rbmj/Geiger_Counter/README.md

This is version 13 of the firmware. It displays counts per second, every second.
