rbmj/Geiger_Counter/Production Files/Geiger_Counter-Panel-v40.brd

## EAGLE design Production/Geiger_Counter-Panel-v40.brd (2014-09-24, last stored version)

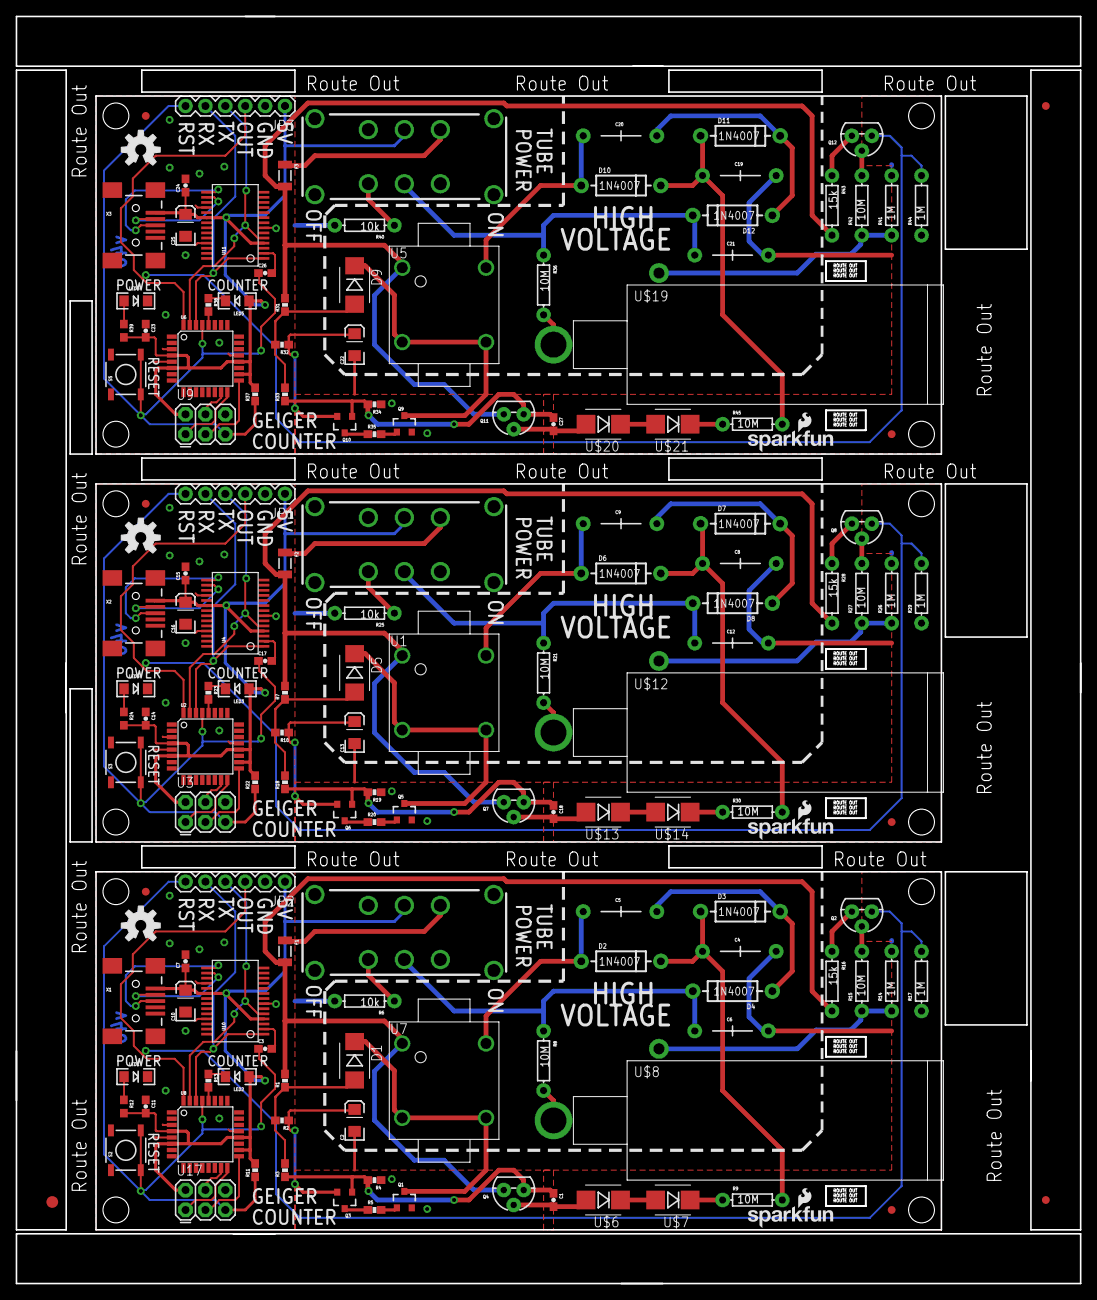
[picture p3: board Geiger_Counter-Panel-v40.brd from above]

Board: 2 copper layers, 135.9 x 161.8 mm, 165 parts (0 on the bottom side), 105 nets.

Parts:
C1, C3, C7, C11, C14, C15, C17, C18, C23, C24, C26, C27: 0.1uF; 0603-CAP
C2, C10, C13, C16, C22, C25: 10uF; EIA3216
C4, C5, C6, C8, C9, C12, C19, C20, C21: 0.01uF; CAP-PTH-LARGE
D1, D5, D9: 1N4007; DIODE-HV
D2, D3, D4, D6, D7, D8, D10, D11, D12: 1N4007; DIODE-1N4001
E$1: FIDUCIAL-1.5X3
E$2, E$3: FIDUCIAL-1X2
F1, F2, F3: PTCSMD; PTC-1206
FID1, FID2, FID3, FID4, FID5, FID6: FIDUCIAL1X2; FIDUCIAL-1X2
JP1, JP2, JP3: debug; 1X06
LED1, LED4, LED6: Red; LED-1206
LED2, LED3, LED5: Green; LED-1206
LOGO1, LOGO3, LOGO5: OSHW-LOGOM; OSHW-LOGO-M
LOGO2, LOGO4, LOGO6: SFE_LOGO_NAME_FLAME.1_INCH; SFE_LOGO_NAME_FLAME_.1
Q1, Q5, Q9: MPSA42; SOT23-3
Q2, Q4, Q7, Q8, Q11, Q12: MPSA18; TO-92
Q3, Q6, Q10: MMBT4403; SOT23-3
R1, R2, R7, R10, R31, R32: 1k; 0603-RES
R3, R18, R33: 100k; 0603-RES
R4, R19, R34: 150k; 0603-RES
R5, R20, R35: 1.8k; 0603-RES
R6, R25, R40: 10k; AXIAL-0.3
R8, R9, R15, R21, R27, R30, R36, R42, R45: 10M; AXIAL-0.3
R11, R22, R37: 10k; 0603-RES
R12, R24, R39: 330; 0603
R13, R23, R38: 330; 0603-RES
R14, R17, R26, R29, R41, R44: 1M; AXIAL-0.3
R16, R28, R43: 15k; AXIAL-0.3
S1, S4, S6: SWITCH-DPDTGPI; GPI-152-3013
S2, S3, S5: Reset; TACTILE_SWITCH_SMD
U1, U5, U7: TRANSFORMERAUDIO; TRANSFORMER
U2, U6, U8: TQFP32-08
U3, U9, U17: AVR_SPI_PRG_6PTH; 2X3
U4, U10, U11: FT232RL-BASICSSOP; SSOP28DB
U$1, U$2, U$3, U$4, U$5, U$9, U$10, U$11, U$15, U$16, U$17, U$18: STAND-OFF
U$6, U$7, U$13, U$14, U$20, U$21: DIODE-ZENERSMB; SMB-DIODE
U$8, U$12, U$19: GEIGER_TUBELND712; GEIGER_TUBE
X1, X2, X3: USBSMD; USB-MINIB

Connections:
5V: C7.1, C10.A, C11.2, JP2.1, LED2.A, R11.2, R12.2, S1.C@1, U8.4, U8.6, U8.18, U8.20, U10.4, U10.20, U17.2, X1.VBUS
5V1: C14.2, C15.1, C16.A, JP1.1, LED3.A, R22.2, R24.2, S4.C@1, U2.4, U2.6, U2.18, U2.20, U3.2, U4.4, U4.20, X2.VBUS
5V2: C23.2, C24.1, C25.A, JP3.1, LED5.A, R37.2, R39.2, S6.C@1, U6.4, U6.6, U6.18, U6.20, U9.2, U11.4, U11.20, X3.VBUS
DTR: C3.2, U10.2
DTR1: C17.2, U4.2
DTR2: C26.2, U11.2
GND: C2.C, C4.2, C6.2, C10.C, C11.1, JP2.2, LED1.C, Q1.2, R4.1, R6.P$2, R14.P$2, R17.P$1, S2.1, S2.2, U8.3, U8.5, U8.21, U10.7, U10.18, U10.21, U10.25, U10.26, U17.6, X1.GND
GND1: C8.2, C12.2, C13.C, C14.1, C16.C, JP1.2, LED4.C, Q5.2, R19.1, R25.P$2, R26.P$2, R29.P$1, S3.1, S3.2, U2.3, U2.5, U2.21, U3.6, U4.7, U4.18, U4.21, U4.25, U4.26, X2.GND
GND2: C19.2, C21.2, C22.C, C23.1, C25.C, JP3.2, LED6.C, Q9.2, R34.1, R40.P$2, R41.P$2, R44.P$1, S5.1, S5.2, U6.3, U6.5, U6.21, U9.6, U11.7, U11.18, U11.21, U11.25, U11.26, X3.GND
HV: C6.1, D4.C, R8.P$1, S1.C@2
HV1: C12.1, D8.C, R21.P$1, S4.C@2
HV2: C21.1, D12.C, R36.P$1, S6.C@2
MCU_RX: JP2.5, U8.30, U10.1
MCU_RX1: JP1.5, U2.30, U4.1
MCU_RX2: JP3.5, U6.30, U11.1
MCU_TX: JP2.4, U8.31, U10.5
MCU_TX1: JP1.4, U2.31, U4.5
MCU_TX2: JP3.4, U6.31, U11.5
MISO: U8.16, U17.1
MISO1: U2.16, U3.1
MISO2: U6.16, U9.1
MOSI: U8.15, U17.4
MOSI1: U2.15, U3.4
MOSI2: U6.15, U9.4
unnamed: F1.1, S1.20
unnamed: D1.A, R1.1, R2.2, R3.2
unnamed: R14.P$1, R15.P$1, U$8.GND
unnamed: C2.A, Q3.2, R2.1
unnamed: Q2.2, R15.P$2
unnamed: Q3.3, R5.1
unnamed: R6.P$1, S1.11
unnamed: Q2.3, R16.P$1
unnamed: Q1.1, R5.2
unnamed: D1.C, Q1.3, U7.2, U7.3
unnamed: C4.1, D2.C, D3.A, R9.P$2
unnamed: C5.2, D3.C, D4.A
unnamed: R8.P$2, U$8.VCC
unnamed: U10.16, X1.D-
unnamed: D5.A, R7.1, R10.2, R18.2
unnamed: U10.15, X1.D+
unnamed: R9.P$1, U$7.C
unnamed: LED1.A, R12.1
unnamed: LED2.C, R13.1
unnamed: R13.2, U8.28
unnamed: U$6.C, U$7.A
unnamed: C1.2, Q4.2, U$6.A
unnamed: C13.A, Q6.2, R10.1
unnamed: Q6.3, R20.1
unnamed: Q5.1, R20.2
unnamed: D5.C, Q5.3, U1.2, U1.3
unnamed: C8.1, D6.C, D7.A, R30.P$2
unnamed: C9.2, D7.C, D8.A
unnamed: R21.P$2, U$12.VCC
unnamed: LED3.C, R23.1
unnamed: R23.2, U2.28
unnamed: U4.16, X2.D-
unnamed: U4.15, X2.D+
unnamed: LED4.A, R24.1
unnamed: R25.P$1, S4.11
unnamed: F2.1, S4.20
unnamed: R26.P$1, R27.P$1, U$12.GND
unnamed: Q8.2, R27.P$2
unnamed: Q8.3, R28.P$1
unnamed: R30.P$1, U$14.C
unnamed: U$13.C, U$14.A
unnamed: C18.2, Q7.2, U$13.A
unnamed: D9.A, R31.1, R32.2, R33.2
unnamed: C22.A, Q10.2, R32.1
unnamed: Q10.3, R35.1
unnamed: Q9.1, R35.2
unnamed: D9.C, Q9.3, U5.2, U5.3
unnamed: C19.1, D10.C, D11.A, R45.P$2
unnamed: C20.2, D11.C, D12.A
unnamed: R36.P$2, U$19.VCC
unnamed: LED5.C, R38.1
unnamed: R38.2, U6.28
unnamed: U11.16, X3.D-
unnamed: U11.15, X3.D+
unnamed: LED6.A, R39.1
unnamed: R40.P$1, S6.11
unnamed: F3.1, S6.20
unnamed: R41.P$1, R42.P$1, U$19.GND
unnamed: Q12.2, R42.P$2
unnamed: Q12.3, R43.P$1
unnamed: R45.P$1, U$21.C
unnamed: U$20.C, U$21.A
unnamed: C27.2, Q11.2, U$20.A
OSC1: C5.1, D2.A, U7.4
OSC2: C1.1, Q3.1, Q4.1, R3.1, R4.2
OSC3: C9.1, D6.A, U1.4
OSC4: C18.1, Q6.1, Q7.1, R18.1, R19.2
OSC5: C20.1, D10.A, U5.4
OSC6: C27.1, Q10.1, Q11.1, R33.1, R34.2
OUT: JP2.3, Q2.1, R17.P$2, U8.32
OUT1: JP1.3, Q8.1, R29.P$2, U2.32
OUT2: JP3.3, Q12.1, R44.P$2, U6.32
RST: C3.1, JP2.6, R11.1, S2.3, S2.4, U8.29, U17.5
RST1: C17.1, JP1.6, R22.1, S3.3, S3.4, U2.29, U3.5
RST2: C26.1, JP3.6, R37.1, S5.3, S5.4, U6.29, U9.5
SCK: U8.17, U17.3
SCK1: U2.17, U3.3
SCK2: U6.17, U9.3
VCC: F1.2, Q4.3, R1.2, R16.P$2, U7.1
VCC1: F2.2, Q7.3, R7.2, R28.P$2, U1.1
VCC2: F3.2, Q11.3, R31.2, R43.P$2, U5.1
