rbmj/Geiger_Counter/(commit log)

2013-10-09 Adding hardware files
    [Geiger_Counter.brd, Geiger_Counter.sch]
2014-04-10 Updated cap/res trace re work
    Updated all caps and res to 0603
    Re routed y junctions to "t" junctions
    Added "high voltage" to btm silk
    updated schematic to frame letter.
    [Geiger_Counter.brd, Geiger_Counter.sch]
2014-04-11 Updated trace sizes and silk
    1.) Updated silk to use non web logo.
    2.) Fixed trace size continuities.
    3.) Scooted LEDs and related resistors for better positioning.
    4.) Couple of trace reroutes to be more efficient.
    5.) Changed silk ratios from 18% to 15% to look cleaner.
    [Geiger_Counter.brd, Geiger_Counter.sch]
2014-07-30 Schematic Cleanup / Trace redo
    [Geiger_Counter.brd, Geiger_Counter.sch]
2014-08-15 Reverting from corrupted files
    [Geiger_Counter.brd, Geiger_Counter.sch]
2014-08-15 Fixed traces and Schematic
    [Geiger_Counter.brd, Geiger_Counter.sch]
2014-08-19 Fixed 4wy Junc / Sch Flags
    [Geiger_Counter.brd, Geiger_Counter.sch]
2014-09-08 added zip tie holes
    [Geiger_Counter.brd]
2014-09-10 added regular fiducial
    [Geiger_Counter.brd, Geiger_Counter.sch]
2014-09-10 created panel v40
    [Geiger_Counter-Panel-v40.brd]
2014-09-24 got rid of mil layer
    [Geiger_Counter-Panel-v40.brd]
2015-03-11 Updating README, fixing directory file name
    [Geiger_Counter-Panel-v40.brd]
2015-06-12 Change programmer conf, add alternate baud.
    4800 baud rate output option needed for the low-power data
    exfil solution.
    Change one or two things on avrdude to allow make program
    to work with the pocket programmer.
    Confirmed known good.
2015-06-17 Only include firmware for the board
    Remove all other files which we're not changing for simplicity.
2015-06-17 Finish delete
    [Geiger_Counter-Panel-v40.brd, Geiger_Counter.brd, Geiger_Counter.sch]
